ValeraKirpich/Pandora-battery-for-PSP-on-arduino/psp go.png

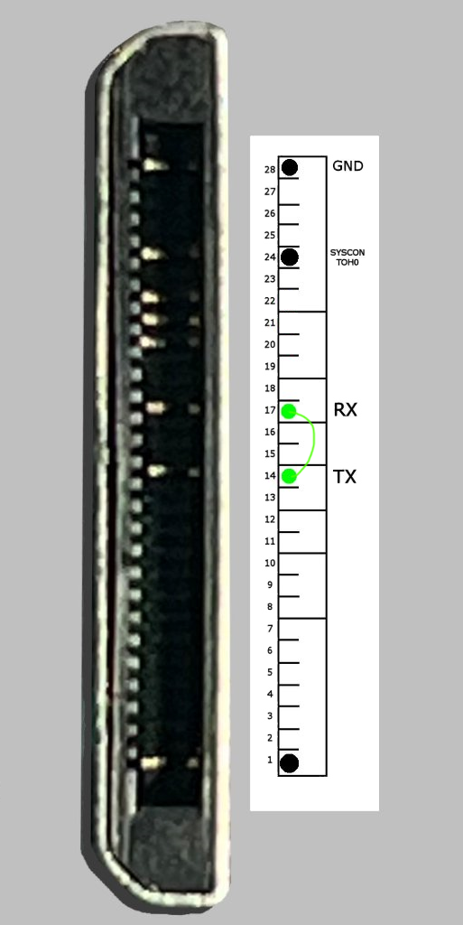
psp go.png
