ValeraKirpich/Pandora-battery-for-PSP-on-arduino/psp street.png

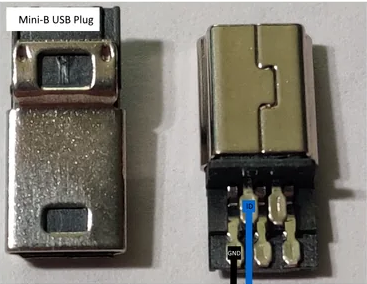
psp street.png
