ValeraKirpich/Pandora-battery-for-PSP-on-arduino/schema CD4011.png

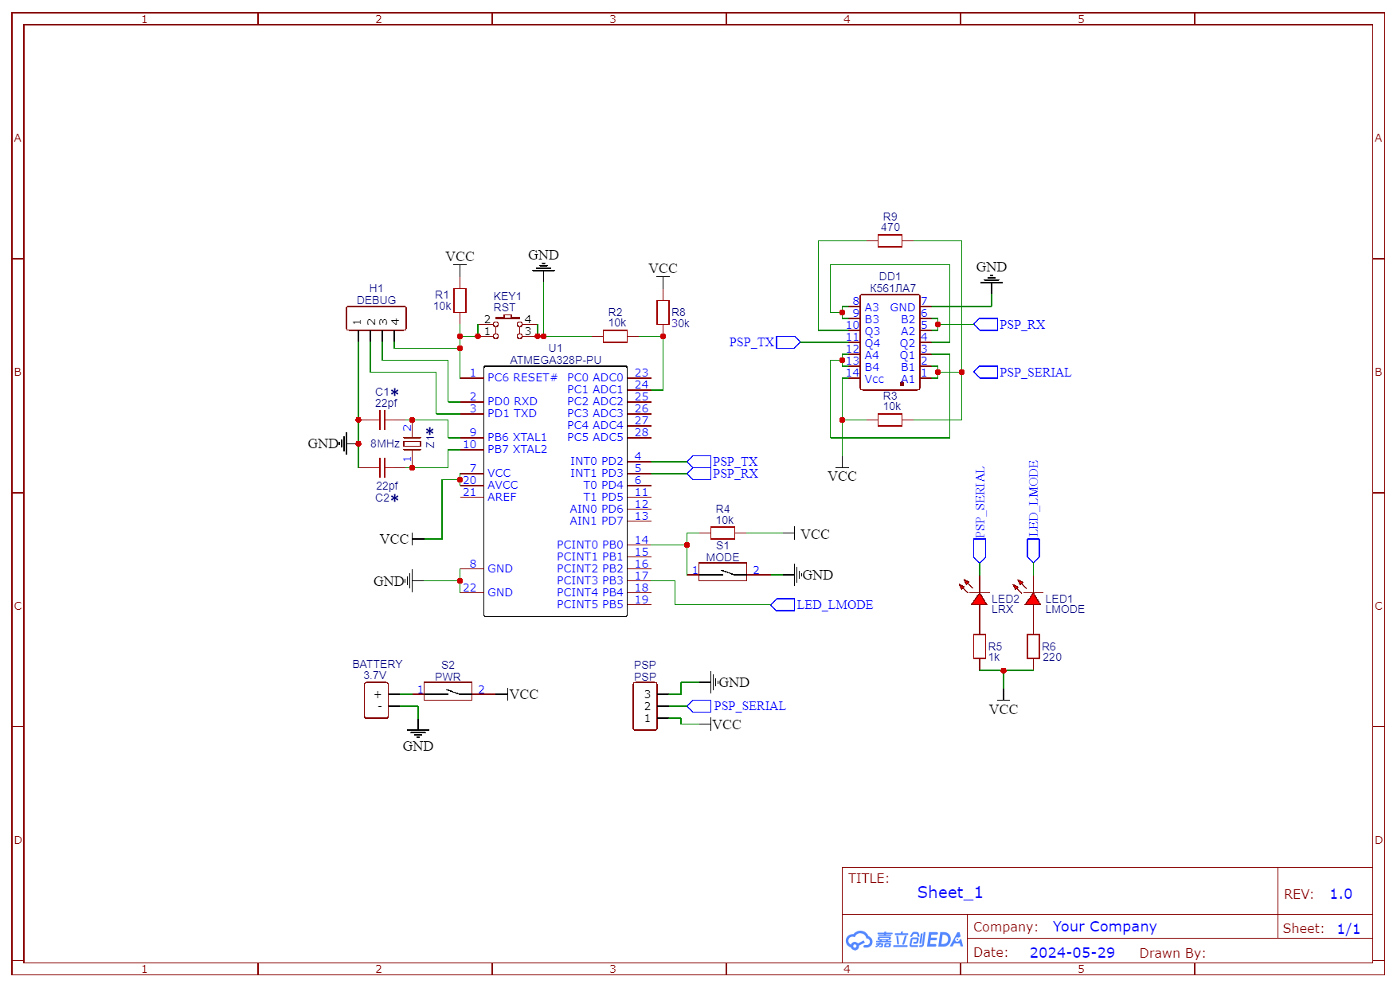
schema CD4011.png
