ValeraKirpich/Pandora-battery-for-PSP-on-arduino/(list of files, drawings)

Other design files:
schema.lay6
