ValeraKirpich/Pandora-battery-for-PSP-on-arduino/(threads)

Thread 1 (2021-12-06):

Схема нормальная где? Не разводка платы.

eXPert-nnm4evr, 2021-12-06:
Почему нет нормальной схемы? Вот я например буду использовать компоненты в SMD исполнении (включая МК (atmega328p) и К561ЛМ7 (CD4011, а точнее HEF4011)), хотелось бы что-бы была нормальная принципиальная схема.

ValeraKirpich, 2021-12-10:
Привет. Я схему и плату хотел переделать под смд, и нарисовать
принципиальную схему, но времени на это пока не могу найти

пн, 6 дек. 2021 г. в 19:57, eXPert-nnm4evr ***@***.***>:

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

eXPert-nnm4evr, 2021-12-15:
Вот быстрый (очень быстрый) набросок схемы в программе DipTrace. Позже могу залить куда-нибудь исходник и необходимые библиотеки.
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

ily25198, 2023-08-26:
Has starred ~Is there a final schematic？

ily25198, 2023-08-27:
> Вот быстрый (очень быстрый) набросок схемы в программе DipTrace. Позже могу залить куда-нибудь исходник и необходимые библиотеки. 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

It seems that there is a 22k less resistance than the author's circuit diagram

ValeraKirpich, 2024-06-20:
Новые схемы добавлены в проект

Closed 2024-06-20.

Thread 2 (2023-06-04):

Gerber file

jas0npc, 2023-06-04:
Can you also include the Gerber file please, Some of us have no way of converting the .lay6 file.

Не могли бы вы также включить файл Gerber, пожалуйста, некоторые из нас не могут преобразовать файл .lay6.

ily25198, 2023-08-28:
There's a problem with the logic gate chip in fact, it's out of stock

ValeraKirpich, 2024-06-20:
Гербер файлы добавлены в проект

Thread 3 (2023-09-01):

Подойдет ли CD4011 без переделки схемы?

bumbec, 2023-09-01:
Подойдет ли CD4011 без переделки схемы?

ily25198, 2023-09-04:
The need to make some design change , only need to change the two and not gate circuit leads is Ok~

bumbec, 2023-09-08:
Отвечу сам себе. Да подходит CD4011B без переделки схемы.

ily25198, 2023-09-10:
Did you manage to build the battery

ily25198, 2023-09-11:
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,I changed the schematic to follow the difference between 57 and CD4011 and not gates

bumbec, 2023-09-11:
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

ily25198, 2023-09-12:
> 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

Great, you also used a smaller package of circuits, this is verified to work?

ily25198, 2023-09-13:
![Uploading 微信图片_20230911014436.jpg…]()

bumbec, 2023-09-14:
[baryon sweeper.zip](https://github.com/ValeraKirpich/Pandora-battery-for-PSP-on-arduino/files/12603182/baryon.sweeper.zip)

ily25198, 2023-09-14:
Thank U~I will make PCB sample ~

jas0npc, 2023-09-14:
> Thank U~I will make PCB sample ~

Could you please post your Gerber file so I can use it with jlcpcb please

ily25198, 2023-09-20:
I haven't had time to do it recently. I'll send it back when it's done

Closed 2023-09-11.
