ValeraKirpich/Pandora-battery-for-PSP-on-arduino/(commit log)

2023-05-05 Обновил плату
    Переразвёл плату, вывел дополнительный пин, уменьшил количество перемычек, добавил выключатель
    [schema.lay6]
2023-05-05 Обновление прошивки
    Добавил ключи для 3000 моделей псп
2023-05-05 Удалил старую прошивку
2023-05-05 Обновил описание
2023-05-25 Add files via upload
    Переписал прошивку. Теперь работают все модели 3000
2023-05-25 Delete Arduino.ino
    Старая прошивка
2023-05-25 Add files via upload
    Обновил плату
    [schema.lay6]
2023-05-25 Update Arduino_v2.ino
    Мелкая правка в номере пина светодиода
2023-06-05 Add files via upload
    Нашёл на плате замыкание дорожки с пяточком на светодиоде
    [schema.lay6]
2023-06-12 Обновил надписи на плате, добавил готовые гербер
    Обновил надписи на плате, добавил готовые гербер файлы
    [schema.lay6]
2023-06-13 Обновление платы и прошивки
    На плате сделал делить напряжения для деления питания с аккумулятора. В прошивке сделал чтение напряжения с делителя через встроенное опорное напряжение 1.1 В. Теперь при низком заряде будет мигать тестовый светодиод.
    [schema.lay6]
2023-06-13 Старый код
2023-06-13 Оптимизация
    Небольшая оптимизация кода, освободил 4% динамической памяти и ускорил работу с портами переключения режима и светодиода
2023-06-13 Обновление прошивки
    Обновил работу светодиода. Теперь он мигает разными режимами
2023-06-13 Update README.md
    Поправил описание работы светодиода
2023-06-26 Update README.md
    Поправил ссылку в описании
2023-08-20 Add files via upload
    Добавил скомпилированные файлы прошивки
2024-05-27 Update README.md
    Поправил описание
2024-05-29 Delete к561ла7.png
    Удалил схему
2024-05-29 Добавил схему
    Добавил новую схему
2024-06-14 Добавил новую схему
2024-06-14 Обновил lay, теперь там два варианта
    [schema.lay6]
2024-06-14 Обновил версию прошивки
    1) Оптимизации
    2) Добавление поддержки psp go
2024-06-14 Добавил скомпилированные бинарники
2024-06-14 Поправил схему на диоде
    [schema.lay6]
2024-06-14 Обновил схемы
    1) Удалил схему на диоде, так как она не рабочая
    2) Перерисовал на смд микросхемах маленький вариант платы
    [schema.lay6]
2024-06-14 Добавил герберы
2024-06-19 Поправил схемы
    Поправил ошибки в схемах
2024-06-20 Новая версия прошивки
    Доработана поддержка psp go
2024-06-20 Новые платы
2024-06-20 Новая печатка
    [schema.lay6]
2024-06-20 Гербер мини платы
2024-07-08 Прибрал код
    Вынес в общие процедуры шифрование и дешифрование
2024-08-01 Update README.md
    Убрал список деталей, так как уже не актуальный
    Добавил ссылку на библиотеку аес
2024-08-01 Добавил фотографии
2024-08-25 Add files via upload
    Поправил резистор R9
2024-08-29 Update README.md
    Добавил список взаимозаменяемых микросхем
2024-09-08 Update README.md
    Добавил инструкцию по использованию и решение проблем
2024-09-10 Update README.md
    Добавил в инструкцию информацию о заряде псп стрит
2024-09-12 Update README.md
    Добавил ещё решение проблем
2024-09-18 Update README.md
    Обновил решение проблем
2024-11-14 Update README.md
    Добавил чистую прошивку 6.61 в описании
2025-10-31 Delete Arduino_v3.2 directory
    Удалил старую прошивку
2025-10-31 Delete GERBER SMD CD4011.zip
    Удалил старую плату
2025-10-31 v4 поддержка обмена уровнем заряда с psp
    1) На схеме изменён резистор с 22к на 30к для корректного определения вольтажа.
    2) Обновлена прошивка. Теперь микроконтроллер умеет определять реальный вольтаж аккумулятора и передавать данные приставке.
    3) Добавлена новая версия smd платы
    [schema.lay6]
2025-10-31 Update README.md
    Обновил описание
2025-10-31 Delete IMG_2024-08-01-13-09-17-202.jpg
    Перенос фото
2025-10-31 Delete IMG_2024-08-01-13-10-03-141.jpg
    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
2025-10-31 Обновил фото
    Добавил фото smd платы
2025-10-31 Update README.md
    Добавил фото в описании
2025-10-31 Обновил фото
    Обрезал фотки
2025-10-31 Правка фото
2025-10-31 Update README.md
    Обновление фото
2025-10-31 Обновление фото
    Почему то фото 3 не обновляется
2025-10-31 Update README.md
    Поправил пропорции фото
2025-10-31 Update README.md
    Добавил в описании уточнение для прошивки мк
2025-10-31 Мелкая правка
    Уменьшил в коде значение с 3,6в до 3,15в, при котором начнём мигать светодиод, сигнализируя пониженный уровень заряда.
2025-10-31 Delete Arduino_v4.0 directory
    обновил прошивку
2025-10-31 Обновление прошивки
    Сделал быстрое мигание светодиодом при уровне заряда менее 3.3в
2025-10-31 Обновление прошивки
    Сделал небольшой фикс для зашиты от перезаряда. Теперь за максимальный заряд будем считать не 4.2в, а 4.18.
2025-10-31 Delete Arduino_v4.1 directory
    Обновил прошивку
2025-10-31 Delete Arduino_v4.2 directory
    Обновление прошивки
2025-10-31 Обновление прошивки
    1) Поправил передачу процента заряда
    2) Поправил расчёт вольтажа аккумулятор
2025-11-01 Delete Arduino_v4_3 directory
    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
2025-11-01 Обновление прошивки
    Поправил передачу процента заряда
2025-11-04 Delete Arduino_v4_4 directory
    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
2025-11-04 Обновление прошивки
    1) Переписал алгоритм расчёта заряда аккумулятора
    2) Добавил
2025-11-04 Delete Arduino_v4_5 directory
    Обновление
2025-11-04 Обновление
    Починил совместимость с go
2025-12-15 Delete Arduino_v4_6 directory
    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
2025-12-15 ОБновление
    В прошивке вынес тайминги светодиода в заголовок
    Схемы переделал под кварц 8мгц
    [schema.lay6]
2025-12-15 Мелкое дополнение
2025-12-15 Добавил скриншоты настроек
2025-12-15 Выделение на фото
2025-12-15 Добавил скриншот настроек
2025-12-15 Обновил скриншот
2025-12-15 Update README.md
    Мелкая правка в тексте
2025-12-15 Правка платы
    Поправил ноги под кварц на smd плате
    [schema.lay6]
2025-12-15 Update README.md
    Добавил вопрос на ответ про кварц 16 мгц
2025-12-15 Обновил платы
    Поправил надпись микроконтроллера на платах
2025-12-15 Пододвинул надписи uart порта
2025-12-29 Update README.md
    Добавил ещё одно решение проблемы, замеченное в ходе тестов
2025-12-29 Update README.md
    Мелкая провка в описании
2026-07-18 Update README.md
    Добавил special thanks
2026-07-19 Update README.md
    Добавил ссылки на авторов в помощь
